pms67/BluePhil/README.md

# BluePhil
 STM32-based development board with various sensors. Update from LittleBrain board. Now includes GPS module, SD card, and CAN transceiver.

Gerber and assembly files ready for order at JLCPCB: https://jlcpcb.com/RPH
