pms67/BluePhil/BluePhil.kicad_pcb

## KiCad design BluePhil.kicad_pcb (2021-03-17)

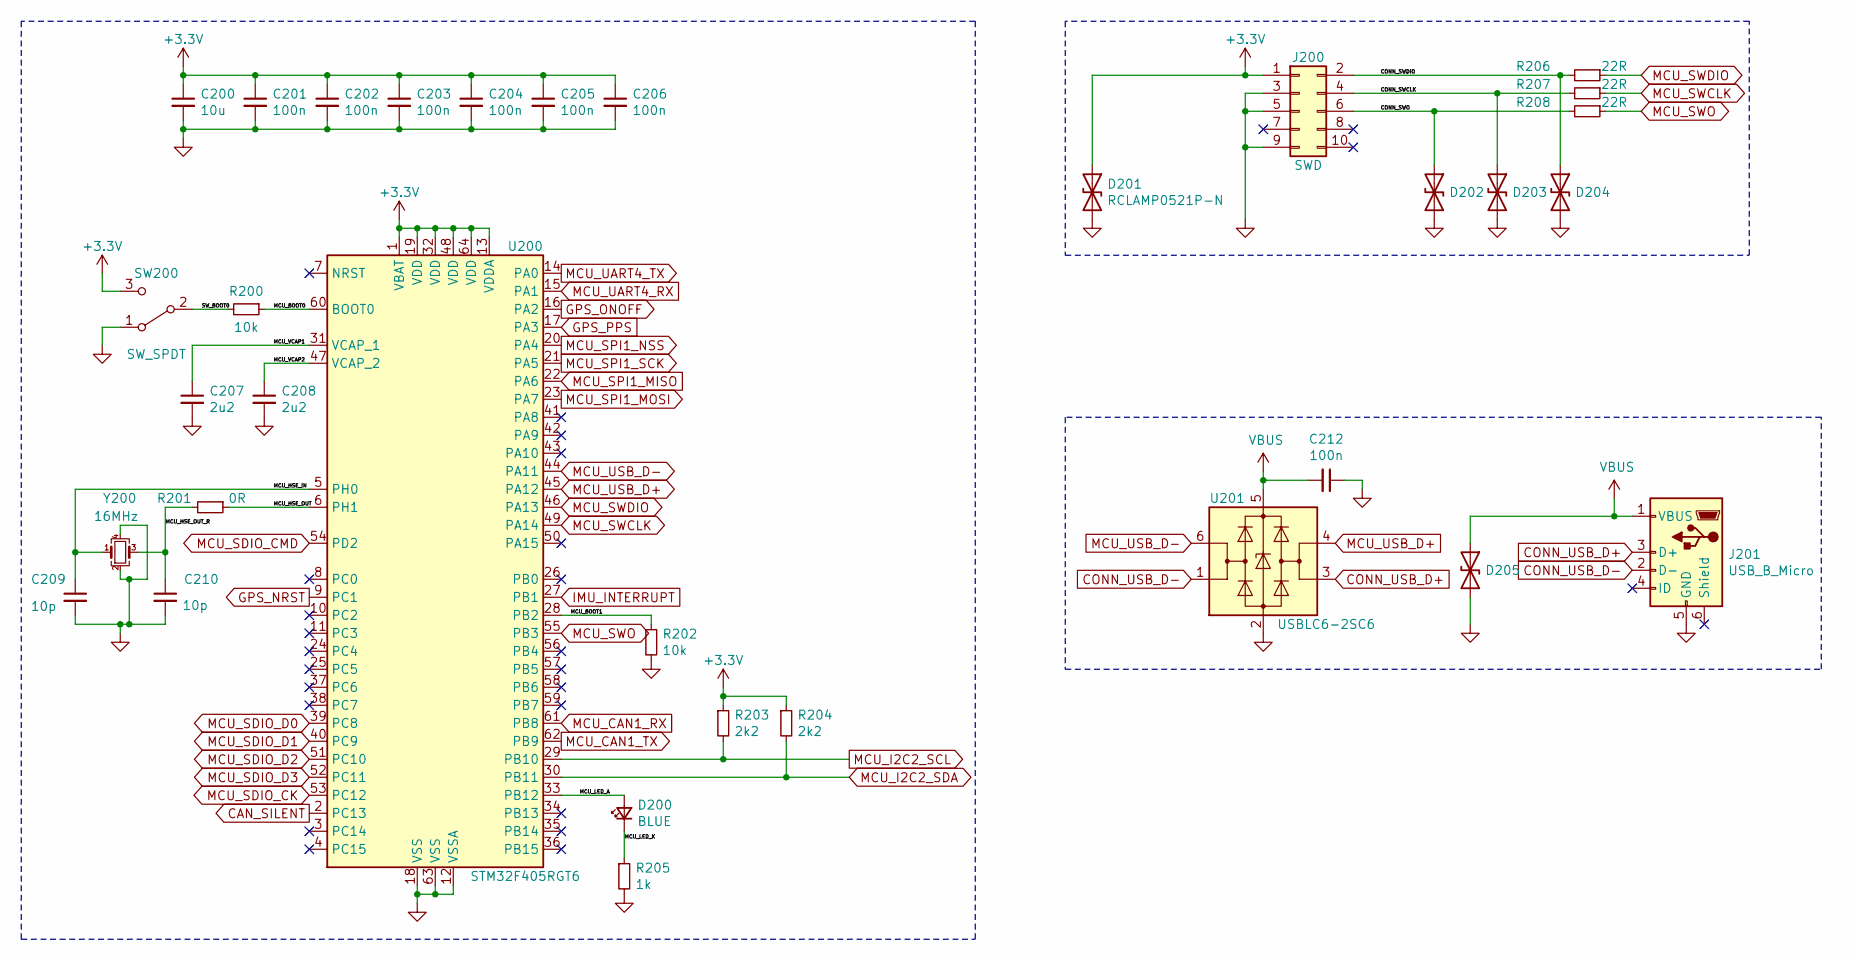
[picture p1: schematic MCU.sch]

Parts:
C200: 10u; C_0603_1608Metric; LCSC Part # C19702
C201, C202, C203, C204, C205, C206, C212: 100n; C_0402_1005Metric; LCSC Part # C1525
C207, C208: 2u2; C_0603_1608Metric; LCSC Part # C23630
C209, C210: 10p; C_0402_1005Metric; LCSC Part # C32949
D200: BLUE; LED_0603_1608Metric; LCSC Part # C72041
D201, D202, D203, D204, D205: RCLAMP0521P-N; D_0402_1005Metric; LCSC Part # C316043
J200: SWD; PinHeader_2x05_P1.27mm_Vertical; LCSC Part # C239059
J201: USB_B_Micro; MicroXNJ; LCSC Part # C404969
R200, R202: 10k; R_0402_1005Metric; LCSC Part # C25744
R201: 0R; R_0402_1005Metric; LCSC Part # C17168
R203, R204: 2k2; R_0402_1005Metric; LCSC Part # C25879
R205: 1k; R_0402_1005Metric; LCSC Part # C11702
R206, R207, R208: 22R; R_0402_1005Metric; LCSC Part # C25092
SW200: SW_SPDT; SW_SPDT_PCM12; LCSC Part # C431541
U200: STM32F405RGT6; LQFP-64_10x10mm_P0.5mm; LCSC Part # C15742
U201: USBLC6-2SC6; SOT-23-6; LCSC Part # C7519
Y200: 16MHz; Crystal_SMD_3225-4Pin_3.2x2.5mm; LCSC Part # C13738

Connections:
+3V3: C200.1, C201.1, C202.1, C203.1, C204.1, C205.1, C206.1, D201.1 (A1), J200.1, R203.1, R204.1, SW200.3 (C), U200.1 (VBAT), U200.13 (VDDA), U200.19 (VDD), U200.32 (VDD), U200.48 (VDD), U200.64 (VDD); also elsewhere on the board
/Microcontroller/CONN_SWCLK: D203.1 (A1), J200.4, R207.2
/Microcontroller/CONN_SWDIO: D204.1 (A1), J200.2, R206.2
/Microcontroller/CONN_SWO: D202.1 (A1), J200.6, R208.2
/Microcontroller/MCU_BOOT0: R200.1, U200.60 (BOOT0)
/Microcontroller/MCU_BOOT1: R202.1, U200.28 (PB2)
/Microcontroller/MCU_HSE_IN: C209.1, U200.5 (PH0), Y200.1
/Microcontroller/MCU_HSE_OUT: R201.1, U200.6 (PH1)
/Microcontroller/MCU_HSE_OUT_R: C210.1, R201.2, Y200.3
/Microcontroller/MCU_LED_A: D200.2 (A), U200.33 (PB12)
/Microcontroller/MCU_LED_K: D200.1 (K), R205.1
/Microcontroller/MCU_VCAP1: C207.1, U200.31 (VCAP_1)
/Microcontroller/MCU_VCAP2: C208.1, U200.47 (VCAP_2)
/Microcontroller/SW_BOOT0: R200.2, SW200.2 (B)
CAN_SILENT: U200.2 (PC13); also elsewhere on the board
CONN_USB_D+: J201.3 (D+), U201.3 (I/O2)
CONN_USB_D-: J201.2 (D-), U201.1 (I/O1)
GND: C200.2, C201.2, C202.2, C203.2, C204.2, C205.2, C206.2, C207.2, C208.2, C209.2, C210.2, C212.1, D201.2 (A2), D202.2 (A2), D203.2 (A2), D204.2 (A2), D205.2 (A2), J200.3, J200.5, J200.9, J201.5 (GND), R202.2, R205.2, SW200.1 (A), U200.12 (VSSA), U200.18 (VSS), U200.63 (VSS), U201.2 (GND), Y200.2, Y200.4; also elsewhere on the board
GPS_NRST: U200.9 (PC1); also elsewhere on the board
GPS_ONOFF: U200.16 (PA2); also elsewhere on the board
GPS_PPS: U200.17 (PA3); also elsewhere on the board
IMU_INTERRUPT: U200.27 (PB1); also elsewhere on the board
MCU_CAN1_RX: U200.61 (PB8); also elsewhere on the board
MCU_CAN1_TX: U200.62 (PB9); also elsewhere on the board
MCU_I2C2_SCL: R203.2, U200.29 (PB10); also elsewhere on the board
MCU_I2C2_SDA: R204.2, U200.30 (PB11); also elsewhere on the board
MCU_SDIO_CK: U200.53 (PC12); also elsewhere on the board
MCU_SDIO_CMD: U200.54 (PD2); also elsewhere on the board
MCU_SDIO_D0: U200.39 (PC8); also elsewhere on the board
MCU_SDIO_D1: U200.40 (PC9); also elsewhere on the board
MCU_SDIO_D2: U200.51 (PC10); also elsewhere on the board
MCU_SDIO_D3: U200.52 (PC11); also elsewhere on the board
MCU_SPI1_MISO: U200.22 (PA6); also elsewhere on the board
MCU_SPI1_MOSI: U200.23 (PA7); also elsewhere on the board
MCU_SPI1_NSS: U200.20 (PA4); also elsewhere on the board
MCU_SPI1_SCK: U200.21 (PA5); also elsewhere on the board
MCU_SWCLK: R207.1, U200.49 (PA14)
MCU_SWDIO: R206.1, U200.46 (PA13)
MCU_SWO: R208.1, U200.55 (PB3)
MCU_UART4_RX: U200.15 (PA1); also elsewhere on the board
MCU_UART4_TX: U200.14 (PA0); also elsewhere on the board
MCU_USB_D+: U200.45 (PA12), U201.4 (I/O2)
MCU_USB_D-: U200.44 (PA11), U201.6 (I/O1)
VBUS: C212.2, D205.1 (A1), J201.1 (VBUS), U201.5 (VBUS); also elsewhere on the board

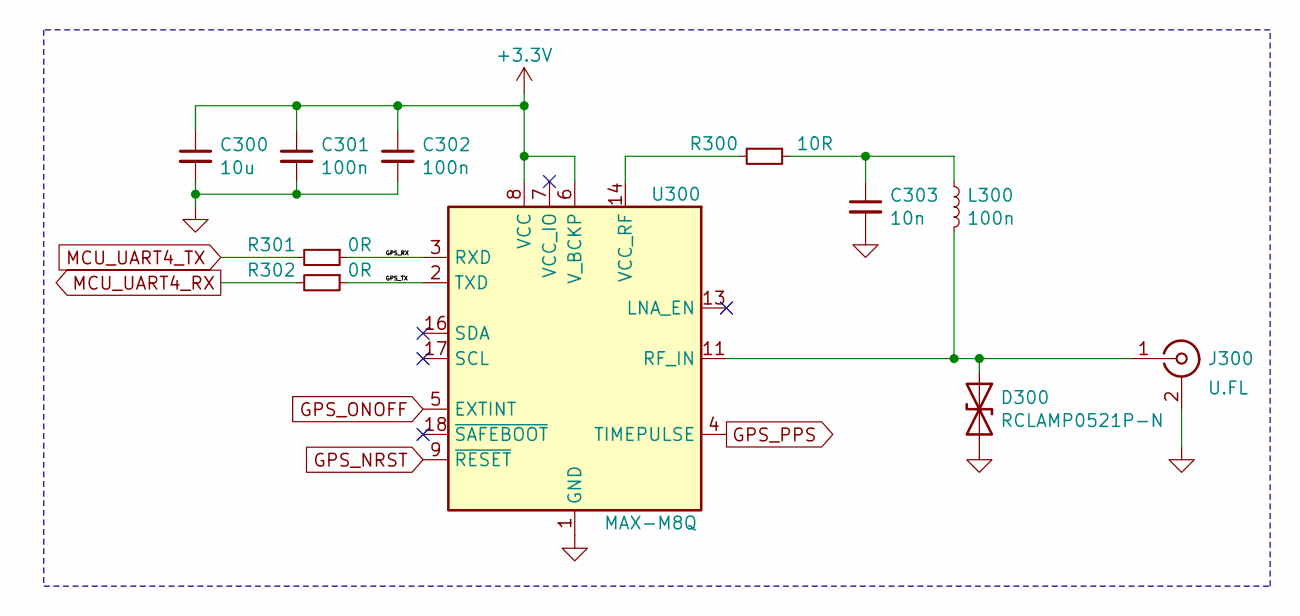
[picture p2: schematic GPS.sch]

Parts:
C300: 10u; C_0603_1608Metric; LCSC Part # C19702
C301, C302: 100n; C_0402_1005Metric; LCSC Part # C1525
C303: 10n; C_0402_1005Metric; LCSC Part # C15195
D300: RCLAMP0521P-N; D_0402_1005Metric; LCSC Part # C316043
J300: U.FL; BWIPX-1-001E; LCSC Part # C496552
L300: 100n; L_0402_1005Metric; LCSC Part # C22726
R300: 10R; R_0402_1005Metric; LCSC Part # C25077
R301, R302: 0R; R_0402_1005Metric; LCSC Part # C17168
U300: MAX-M8Q; ublox_MAX; LCSC Part # C90770

Connections:
+3V3: C300.1, C301.1, C302.1, U300.6 (V_BCKP), U300.8 (VCC); also elsewhere on the board
/GPS/GPS_RX: R301.1, U300.3 (RXD)
/GPS/GPS_TX: R302.1, U300.2 (TXD)
GND: C300.2, C301.2, C302.2, C303.2, D300.2 (A2), J300.2 (Ext), U300.1 (GND), U300.10 (GND), U300.12 (GND); also elsewhere on the board
GPS_NRST: U300.9 (~RESET); also elsewhere on the board
GPS_ONOFF: U300.5 (EXTINT); also elsewhere on the board
GPS_PPS: U300.4 (TIMEPULSE); also elsewhere on the board
MCU_UART4_RX: R302.2; also elsewhere on the board
MCU_UART4_TX: R301.2; also elsewhere on the board
unnamed: C303.1, L300.1, R300.1
unnamed: D300.1 (A1), J300.1 (In), L300.2, U300.11 (RF_IN)
unnamed: R300.2, U300.14 (VCC_RF)

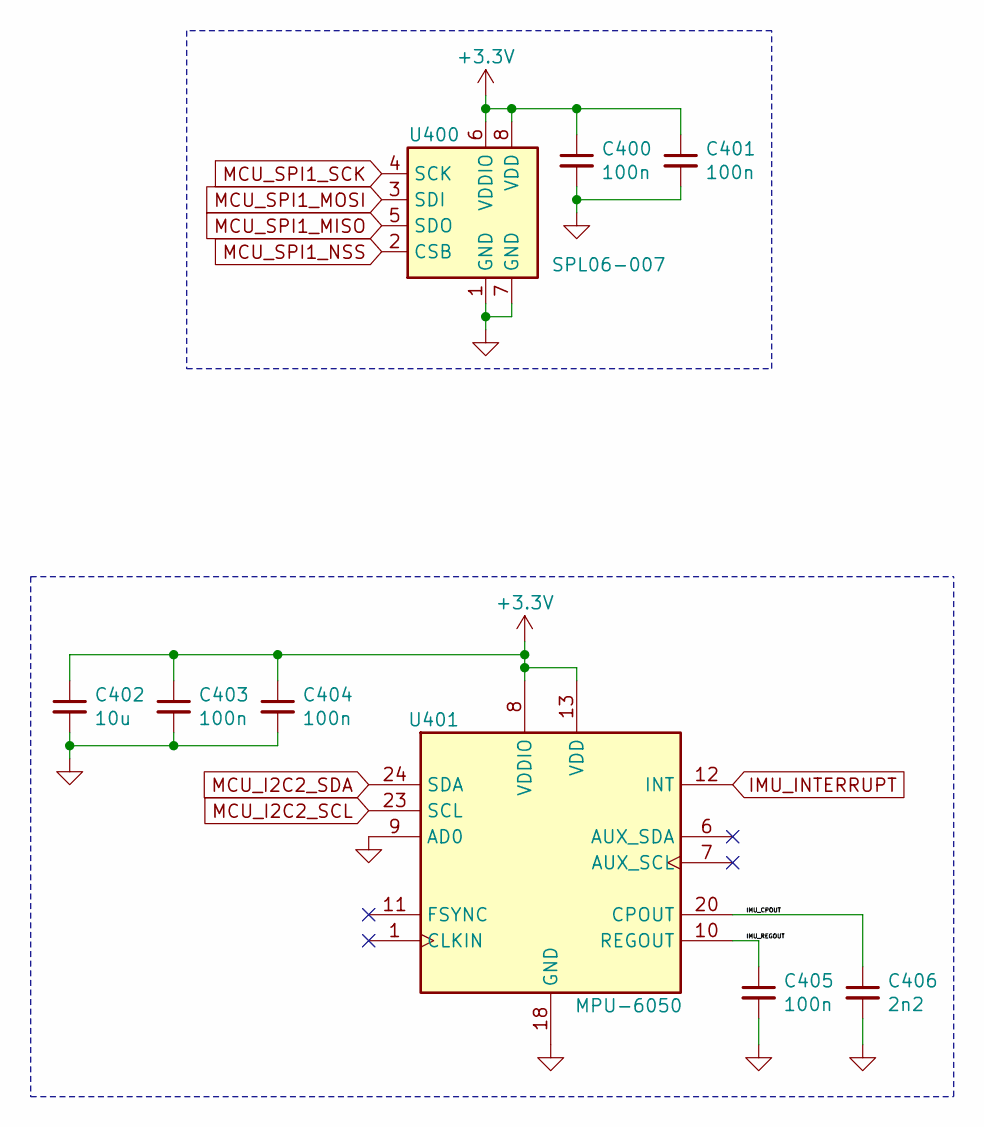
[picture p3: schematic Sensors.sch]

Parts:
C400, C401, C403, C404, C405: 100n; C_0402_1005Metric; LCSC Part # C1525
C402: 10u; C_0603_1608Metric; LCSC Part # C19702
C406: 2n2; C_0402_1005Metric; LCSC Part # C1531
U400: SPL06-007; Bosch_LGA-8_2x2.5mm_P0.65mm_ClockwisePinNumbering; LCSC Part # C233787
U401: MPU-6050; InvenSense_QFN-24_4x4mm_P0.5mm; LCSC Part # C24112

Connections:
+3V3: C400.1, C401.1, C402.1, C403.1, C404.1, U400.6 (VDDIO), U400.8 (VDD), U401.8 (VDDIO), U401.13 (VDD); also elsewhere on the board
/Sensors/IMU_CPOUT: C406.1, U401.20 (CPOUT)
/Sensors/IMU_REGOUT: C405.1, U401.10 (REGOUT)
GND: C400.2, C401.2, C402.2, C403.2, C404.2, C405.2, C406.2, U400.1 (GND), U400.7 (GND), U401.9 (AD0), U401.18 (GND); also elsewhere on the board
IMU_INTERRUPT: U401.12 (INT); also elsewhere on the board
MCU_I2C2_SCL: U401.23 (SCL); also elsewhere on the board
MCU_I2C2_SDA: U401.24 (SDA); also elsewhere on the board
MCU_SPI1_MISO: U400.5 (SDO); also elsewhere on the board
MCU_SPI1_MOSI: U400.3 (SDI); also elsewhere on the board
MCU_SPI1_NSS: U400.2 (CSB); also elsewhere on the board
MCU_SPI1_SCK: U400.4 (SCK); also elsewhere on the board

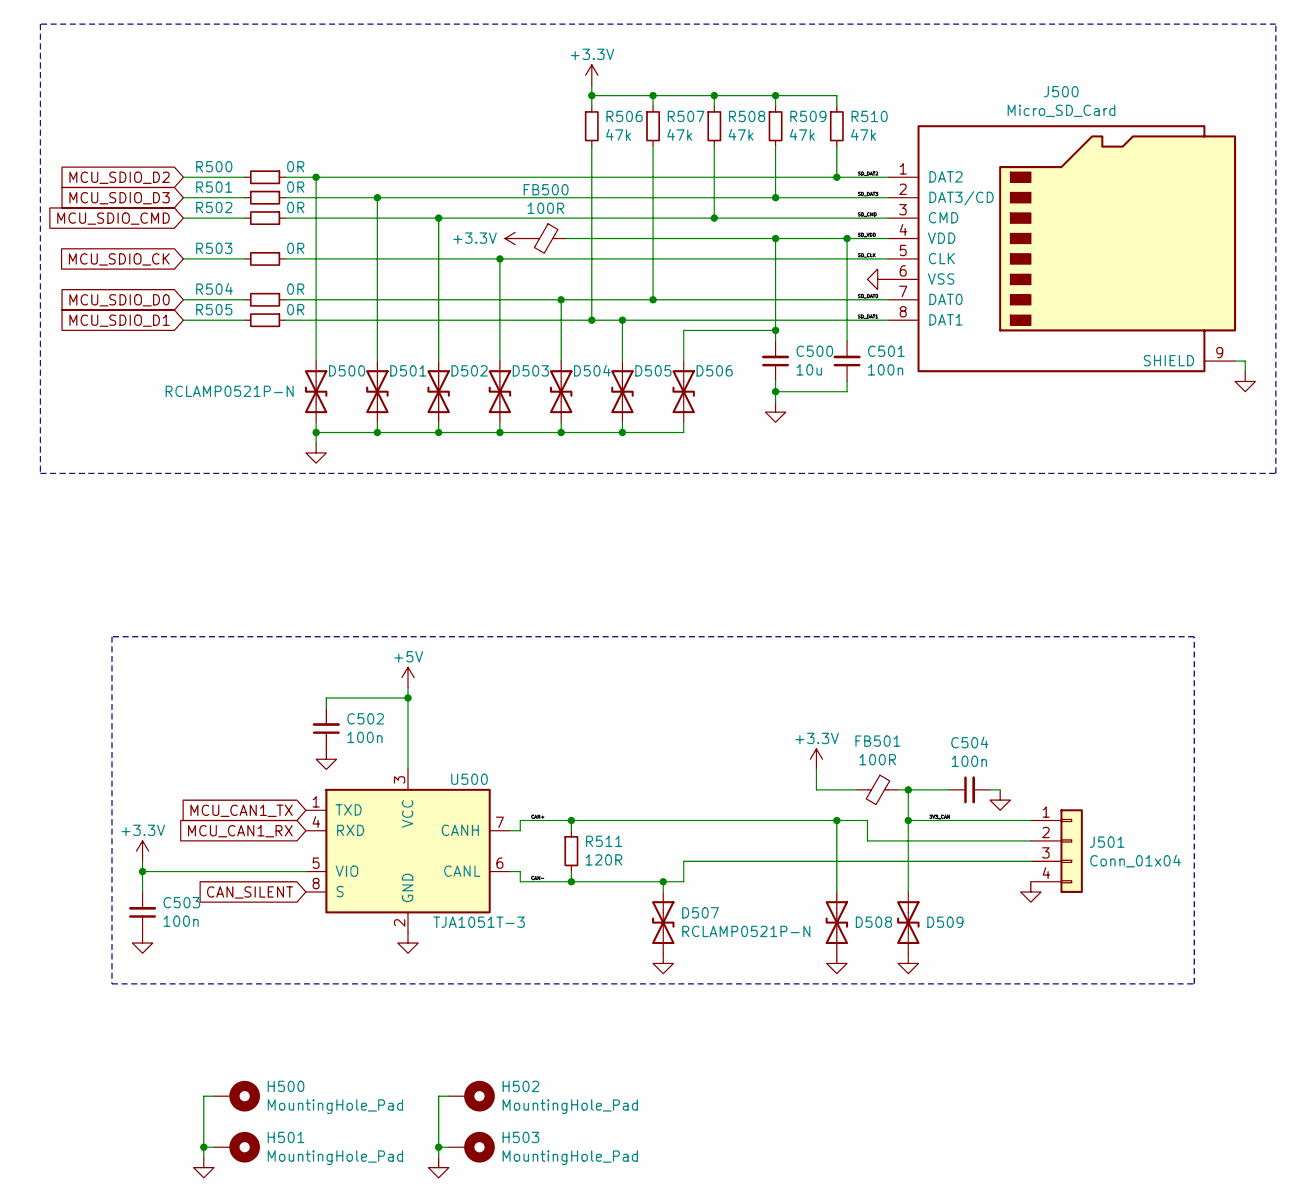
[picture p4: schematic Misc.sch]

Parts:
C500: 10u; C_0603_1608Metric; LCSC Part # C19702
C501, C502, C503, C504: 100n; C_0402_1005Metric; LCSC Part # C1525
D500, D501, D502, D503, D504, D505, D506, D507, D508, D509: RCLAMP0521P-N; D_0402_1005Metric; LCSC Part # C316043
FB500, FB501: 100R; L_0603_1608Metric; LCSC Part # C1002
H500, H501, H502, H503: MountingHole_Pad; MountingHole_3.2mm_M3_Pad_Via
J500: Micro_SD_Card; TF-102-15; LCSC Part # C266609
J501: Conn_01x04; PinHeader_1x04_P2.54mm_Vertical
R500, R501, R502, R503, R504, R505: 0R; R_0402_1005Metric; LCSC Part # C17168
R506, R507, R508, R509, R510: 47k; R_0402_1005Metric; LCSC Part # C25792
R511: 120R; R_0402_1005Metric; LCSC Part # C25079
U500: TJA1051T-3; SOIC-8_3.9x4.9mm_P1.27mm; LCSC Part # C38695

Connections:
+3V3: C503.2, FB500.2, FB501.2, R506.1, R507.1, R508.1, R509.1, R510.1, U500.5 (VIO); also elsewhere on the board
+5V: C502.2, U500.3 (VCC); also elsewhere on the board
/Miscellaneous/3V3_CAN: C504.1, D509.1 (A1), FB501.1, J501.1
/Miscellaneous/CAN+: D508.1 (A1), J501.2, R511.1, U500.7 (CANH)
/Miscellaneous/CAN-: D507.1 (A1), J501.3, R511.2, U500.6 (CANL)
/Miscellaneous/SD_CLK: D503.1 (A1), J500.5 (CLK), R503.1
/Miscellaneous/SD_CMD: D502.1 (A1), J500.3 (CMD), R502.1, R508.2
/Miscellaneous/SD_DAT0: D504.1 (A1), J500.7 (DAT0), R504.1, R507.2
/Miscellaneous/SD_DAT1: D505.1 (A1), J500.8 (DAT1), R505.1, R506.2
/Miscellaneous/SD_DAT2: D500.1 (A1), J500.1 (DAT2), R500.1, R510.2
/Miscellaneous/SD_DAT3: D501.1 (A1), J500.2 (DAT3/CD), R501.1, R509.2
/Miscellaneous/SD_VDD: C500.2, C501.2, D506.1 (A1), FB500.1, J500.4 (VDD)
CAN_SILENT: U500.8 (S); also elsewhere on the board
GND: C500.1, C501.1, C502.1, C503.1, C504.2, D500.2 (A2), D501.2 (A2), D502.2 (A2), D503.2 (A2), D504.2 (A2), D505.2 (A2), D506.2 (A2), D507.2 (A2), D508.2 (A2), D509.2 (A2), H500.1, H501.1, H502.1, H503.1, J500.6 (VSS), J500.9 (SHIELD), J501.4, U500.2 (GND); also elsewhere on the board
MCU_CAN1_RX: U500.4 (RXD); also elsewhere on the board
MCU_CAN1_TX: U500.1 (TXD); also elsewhere on the board
MCU_SDIO_CK: R503.2; also elsewhere on the board
MCU_SDIO_CMD: R502.2; also elsewhere on the board
MCU_SDIO_D0: R504.2; also elsewhere on the board
MCU_SDIO_D1: R505.2; also elsewhere on the board
MCU_SDIO_D2: R500.2; also elsewhere on the board
MCU_SDIO_D3: R501.2; also elsewhere on the board

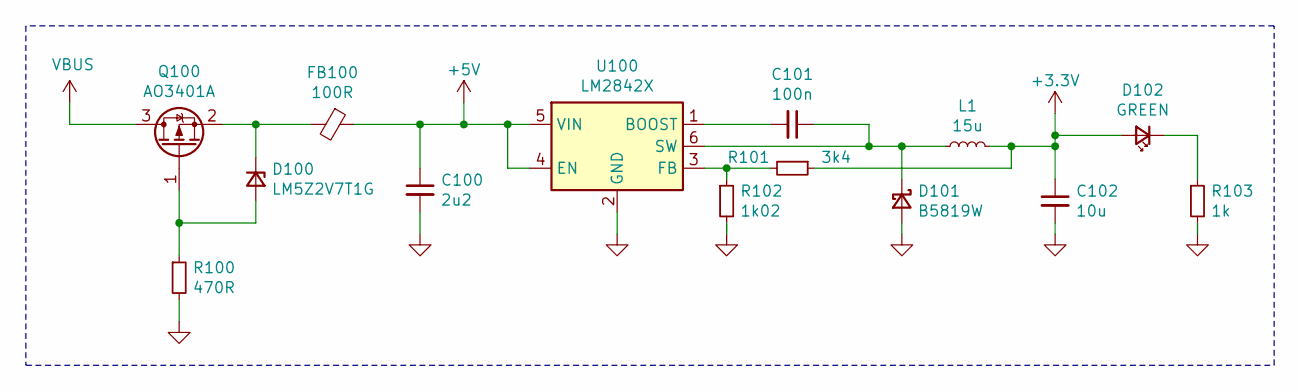
[picture p5: schematic Power.sch]

Parts:
C100: 2u2; C_0603_1608Metric; LCSC Part # C23630
C101: 100n; C_0402_1005Metric; LCSC Part # C1525
C102: 10u; C_0603_1608Metric; LCSC Part # C19702
D100: LM5Z2V7T1G; D_SOD-523; LCSC Part # C131797
D101: B5819W; D_SOD-123; LCSC Part # C8598
D102: GREEN; LED_0603_1608Metric; LCSC Part # C72043
FB100: 100R; L_0603_1608Metric; LCSC Part # C1002
L1: 15u; MPIT4018-150M-LF; LCSC Part # C281265
Q100: AO3401A; SOT-23; LCSC Part # C693260
R100: 470R; R_0402_1005Metric; LCSC Part # C25117
R101: 3k4; R_0402_1005Metric; LCSC Part # C4940
R102: 1k02; R_0402_1005Metric; LCSC Part # C85373
R103: 1k; R_0402_1005Metric; LCSC Part # C11702
U100: LM2842X; TSOT-23-6; LCSC Part # C9403

Connections:
+3V3: C102.1, D102.2 (A), L1.2, R101.1; also elsewhere on the board
+5V: C100.1, FB100.1, U100.4 (EN), U100.5 (VIN); also elsewhere on the board
GND: C100.2, C102.2, D101.2 (A), R100.2, R102.2, R103.2, U100.2 (GND); also elsewhere on the board
unnamed: C101.1, D101.1 (K), L1.1, U100.6 (SW)
unnamed: C101.2, U100.1 (BOOST)
unnamed: D100.1 (K), FB100.2, Q100.2 (S)
unnamed: D100.2 (A), Q100.1 (G), R100.1
unnamed: D102.1 (K), R103.1
unnamed: R101.2, R102.1, U100.3 (FB)
VBUS: Q100.3 (D); also elsewhere on the board

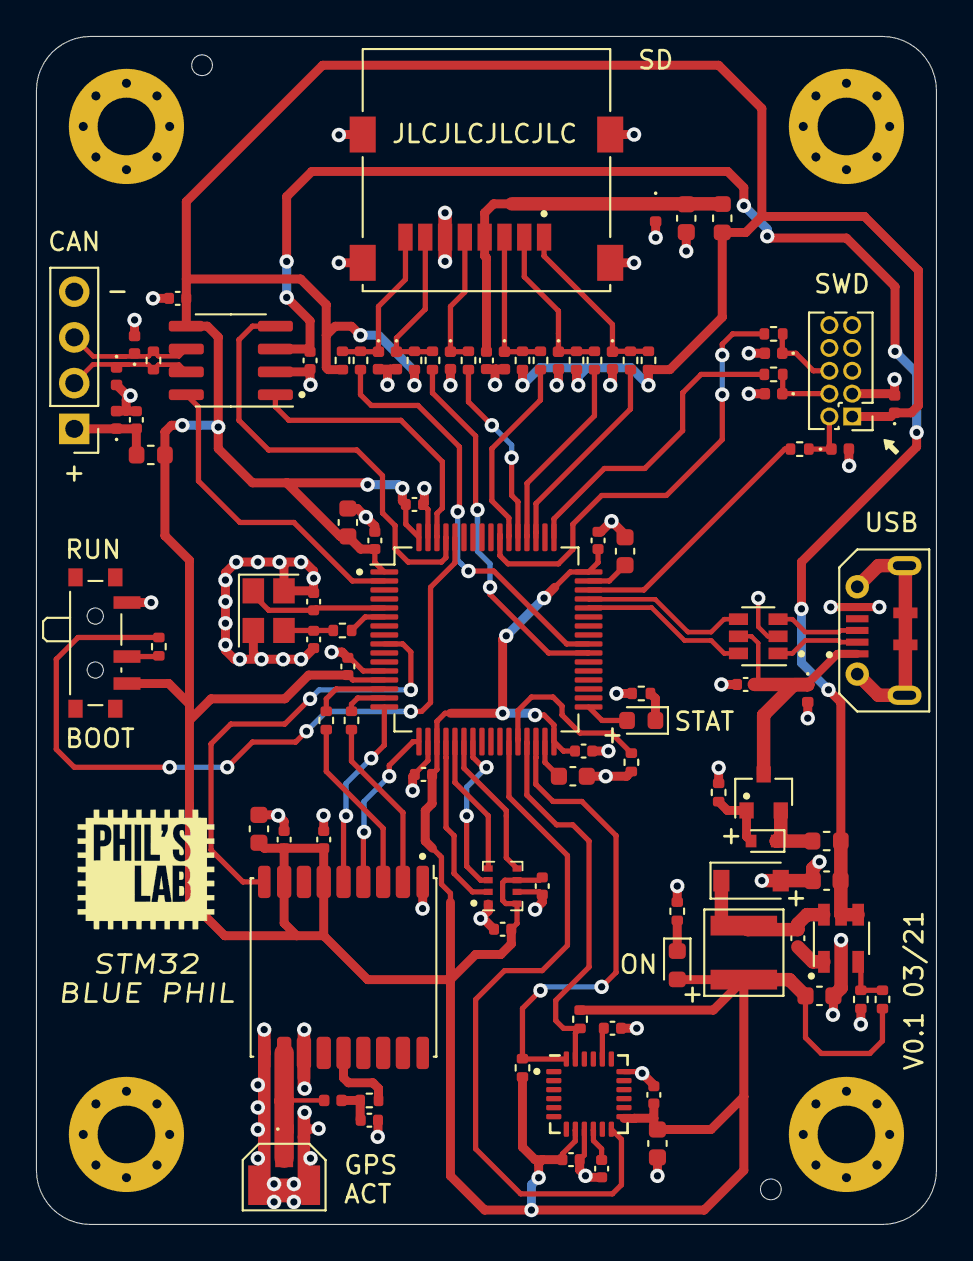
[picture p6: board BluePhil.kicad_pcb from above]

Board: 2 copper layers, 50.0 x 66.0 mm, 103 parts (0 on the bottom side), 68 nets.
