pms67/BluePhil/(threads)

Thread 1 (2021-06-15):

Ferrite Bead Value mismatch.

davidc0le, 2021-06-15:
Thanks for releasing this design.

A question on the ferrite bead value - the schematic shows a value of 100R but the LCSC part is 600ohm @ 100Mhz.  Is this the correct LCSC part ?

Thanks
